goose1987/podfm/README.md

podfm
=====

fm transmitter adapter for ipod
