goose1987/podfm/BOM.xlsx

Part | Value | Device | Package | Description | MF | MPN | OC_NEWARK | OC_DIGIKEY | QTY
C1 | 10uF | C-EUC1206 | C1206 | CAPACITOR, European symbol
C2 | 0.1uF | C-EUC1206 | C1206 | CAPACITOR, European symbol
C5 | 0.1u | C-EUC1206 | C1206 | CAPACITOR, European symbol
C6 |  | C-EUC1206 | C1206 | CAPACITOR, European symbol
C7 |  | C-EUC1206 | C1206 | CAPACITOR, European symbol
C8 | 0.1uF | C-EUC1206 | C1206 | CAPACITOR, European symbol
D1 | MBR0520LT | MBR0520LT | SOD123 | SCHOTTKY BARRIER RECTIFIER |  |  |  |  | 3
D2 | MBR0520LT | MBR0520LT | SOD123 | SCHOTTKY BARRIER RECTIFIER |  |  |  |  | 3
IC1 | ATMEGA168-AU | ATMEGA168-AU | TQFP32-08 |  |  |  |  | ATMEGA168-20AU-ND | 3
IC2 | FT232RL | FT232RL | SSOP28 | FTDI USB chip |  | FT232RL | 91K9918 | 768-1007-1-ND | 3
LED1 |  | LED_ESML0603 | LED_SML0603 | LED
LED2 |  | LED_ESML0603 | LED_SML0603 | LED
LED3 |  | LED_ESML0603 | LED_SML0603 | LED
Q1 |  | CRYSTALTC26H | TC26H | CRYSTAL |  |  | unknown
R1 | 10k | R-US_R1206 | R1206 | RESISTOR, American symbol
R2 | 10k | R-US_R1206 | R1206 | RESISTOR, American symbol
R3 | 1k | R-US_R1206 | R1206 | RESISTOR, American symbol
R4 | 1k | R-US_R1206 | R1206 | RESISTOR, American symbol
R5 | 680 | R-US_R0805 | R0805 | RESISTOR, American symbol
R6 | 680 | R-US_R0805 | R0805 | RESISTOR, American symbol
R7 | 1k | R-US_R1206 | R1206 | RESISTOR, American symbol
R8 | 10k | R-US_R1206 | R1206 | RESISTOR, American symbol
R9 | 10k | R-US_R1206 | R1206 | RESISTOR, American symbol
R12 | 10k | R-US_R1206 | R1206 | RESISTOR, American symbol
S1 |  | 10-XX | B3F-10XX | OMRON SWITCH |  | B3F-1000 | 36M3542
U$1 | NS73 | NS73 | NS73
U$2 | IPOD-DOCK-CONNECTOR | IPOD-DOCK-CONNECTOR | IPOD_CONNECTOR
U$3 | CSTCE_V | CSTCE_V | CSTCE_V |  |  |  |  | 490-1198-1-ND | 3
X1 | MINI-USB-32005-301 | MINI-USB-32005-301 | 32005-301 | MINI USB-B Conector |  |  | unknown
X2 | R141426 | R141426 | R141426 | BNC COAX CONNECTOR | FARNELL | R141426161 | 14J7919
