goose1987/podfm/podfm.brd

## EAGLE design podfm.brd (2013-09-22)

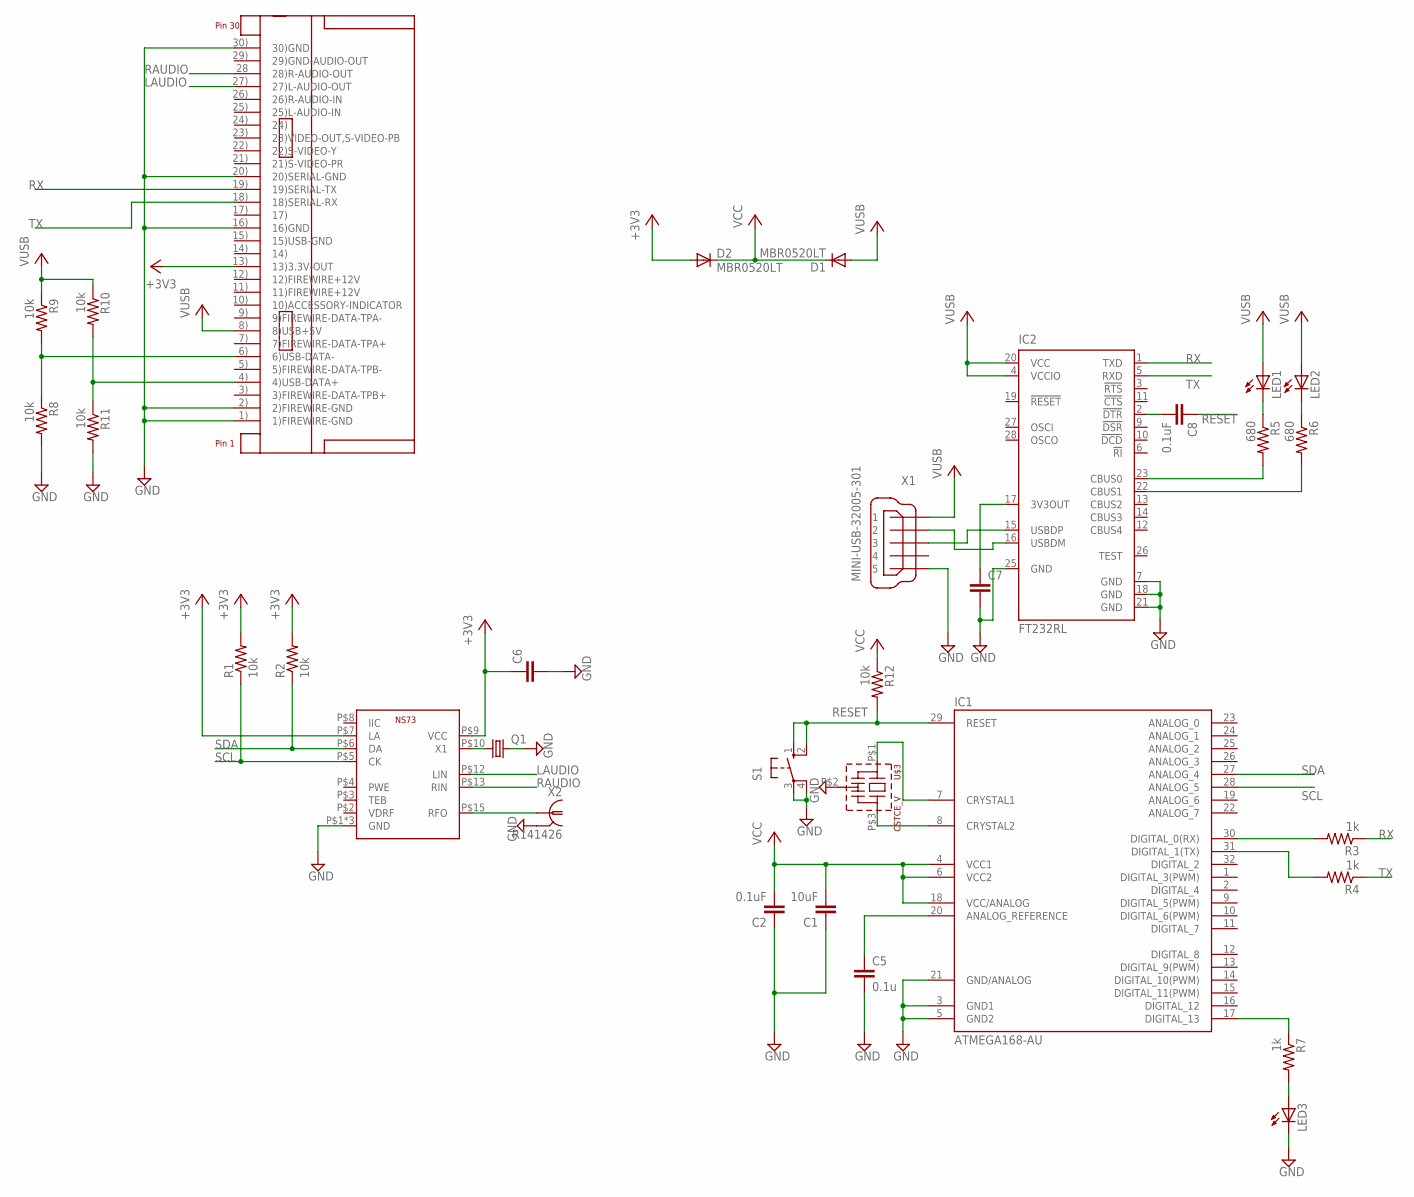
[picture p1: schematic podfm.sch]

Parts:
C1: 10uF; C1206
C2, C8: 0.1uF; C1206
C5: 0.1u; C1206
C6, C7: C-EUC1206; C1206
D1, D2: MBR0520LT; SOD123
IC1: ATMEGA168-AU; TQFP32-08
IC2: FT232RL; SSOP28
LED1, LED2, LED3: LED_ESML0603; LED_SML0603
Q1: CRYSTALTC26H; TC26H
R1, R2, R8, R9, R10, R11, R12: 10k; R1206
R3, R4, R7: 1k; R1206
R5, R6: 680; R0805
S1: 10-XX; B3F-10XX
U$1: NS73
U$2: IPOD-DOCK-CONNECTOR; IPOD_CONNECTOR
U$3: CSTCE_V
X1: MINI-USB-32005-301; 32005-301
X2: R141426

Connections:
+3V3: C6.1, D2.A, R1.2, R2.2, U$1.P$7 (LA), U$1.P$9 (VCC), U$2.13) (13)3.3V-OUT)
GND: C1.1, C2.1, C5.2, C6.2, C7.2, IC1.3 (GND1), IC1.5 (GND2), IC1.21 (GND/ANALOG), IC2.7 (GND), IC2.18 (GND), IC2.21 (GND), IC2.25 (GND), LED3.C, Q1.2, R8.2, R11.2, S1.3, S1.4 (P1), U$1.P$1 (GND), U$1.P$11 (GND), U$1.P$14 (GND), U$2.1) (1)FIREWIRE-GND), U$2.2) (2)FIREWIRE-GND), U$2.16) (16)GND), U$2.20) (20)SERIAL-GND), U$2.30) (30)GND), U$3.P$2 (VSS), X1.5, X1.M1 (5), X1.M2 (5), X1.M3 (5), X1.M4 (5), X2.2, X2.3 (2), X2.4 (2), X2.5 (2)
LAUDIO: U$1.P$12 (LIN), U$2.27) (27)L-AUDIO-OUT)
unnamed: U$1.P$15 (RFO), X2.1
unnamed: IC2.15 (USBDP), X1.3
unnamed: IC2.16 (USBDM), X1.2
unnamed: IC2.23 (CBUS0), R5.2
unnamed: IC2.22 (CBUS1), R6.2
unnamed: Q1.1, U$1.P$10 (X1)
unnamed: R10.2, R11.1, U$2.4) (4)USB-DATA+)
unnamed: R8.1, R9.2, U$2.6) (6)USB-DATA-)
unnamed: C7.1, IC2.17 (3V3OUT)
unnamed: IC1.30 (DIGITAL_0(RX)), R3.2
unnamed: IC1.31 (DIGITAL_1(TX)), R4.2
unnamed: C5.1, IC1.20 (ANALOG_REFERENCE)
unnamed: LED1.C, R5.1
unnamed: C8.2, IC2.2 (!DTR)
unnamed: LED2.C, R6.1
unnamed: IC1.17 (DIGITAL_13), R7.1
unnamed: LED3.A, R7.2
unnamed: IC1.7 (CRYSTAL1), U$3.P$1 (1)
unnamed: IC1.8 (CRYSTAL2), U$3.P$3 (3)
RAUDIO: U$1.P$13 (RIN), U$2.28 (28)R-AUDIO-OUT)
RESET: C8.1, IC1.29 (RESET), R12.2, S1.1 (S), S1.2 (S1)
RX: IC2.1 (TXD), R3.1, U$2.19) (19)SERIAL-TX)
SCL: IC1.28 (ANALOG_5), R1.1, U$1.P$5 (CK)
SDA: IC1.27 (ANALOG_4), R2.1, U$1.P$6 (DA)
TX: IC2.5 (RXD), R4.1, U$2.18) (18)SERIAL-RX)
VCC: C1.2, C2.2, D1.C, D2.C, IC1.4 (VCC1), IC1.6 (VCC2), IC1.18 (VCC/ANALOG), R12.1
VUSB: D1.A, IC2.4 (VCCIO), IC2.20 (VCC), LED1.A, LED2.A, R9.1, R10.1, U$2.8) (8)USB+5V), X1.1

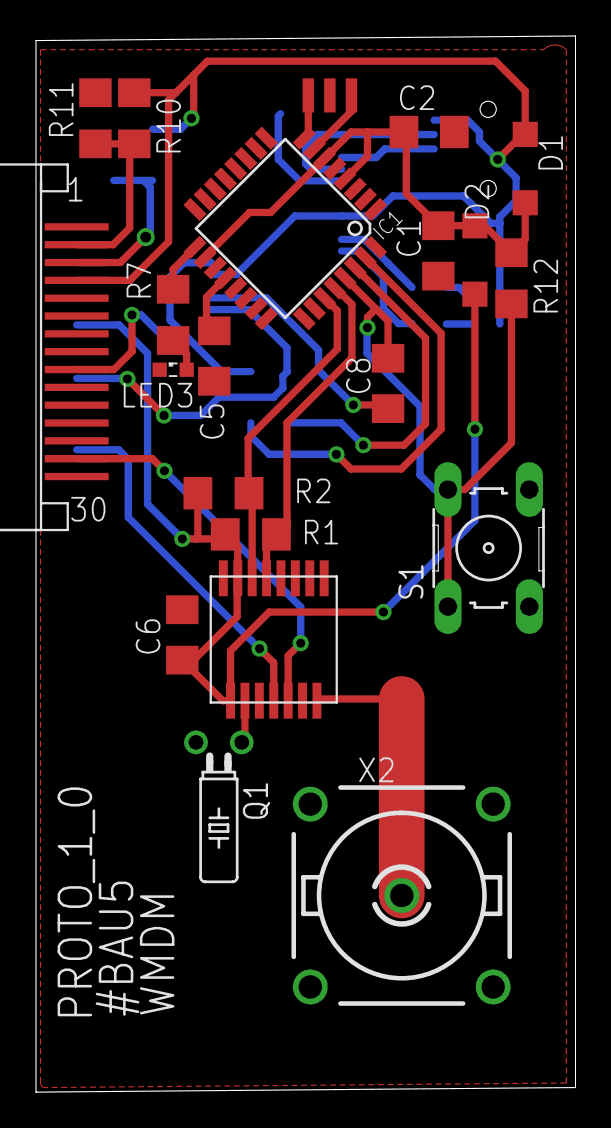
[picture p2: board podfm.brd from above]

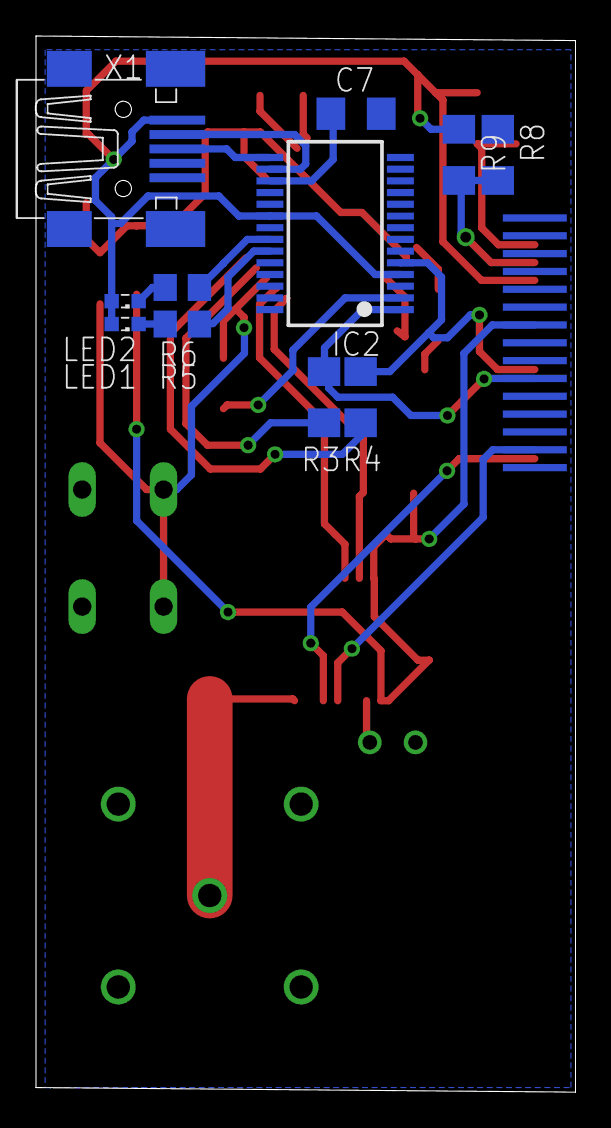
[picture p3: board podfm.brd from below]

Board: 2 copper layers, 30.0 x 58.7 mm, 32 parts (11 on the bottom side), 30 nets.
