goose1987/podfm/(commit log)

2013-08-31 Hoang Pham 8/31/2013 initial board and schematic
    [arduinoFMShield.brd, arduinoFMShield.sch]
2013-08-31 8/31/2013 Changed FTDI chip and atmega to bigger package for easier soldering. Add murata resonator
    [arduinoFMShield.brd, arduinoFMShield.sch]
2013-09-01 8/31/2013 Fixed board dimension Moved silkscreen designator around for better visibility
    [arduinoFMShield.brd]
2013-09-01 8/31/2013
    Created BOM
    renamed schematic and board file to be more
    consistent with project
    [BOM.xlsx, podfm.brd, podfm.sch]
2013-09-22 9/22/2013 fixed usb connection 1-VCC 2-data- 3-data+ 5-GND added resistor network for ipod iphone charging Signed-off-by: goose1987 <phamh1987@gmail.com>
    [BOM.xlsx, podfm.brd, podfm.sch]
